AdaptiveTechnology/FEED.ME/3D Models/Clamp Boot.SLDPRT

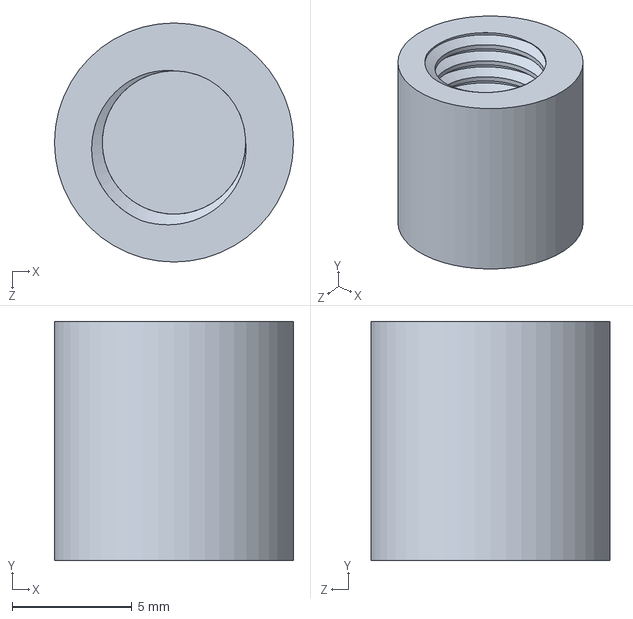
[picture p10: CAD file, 2019-04-22]
3D Models/Clamp Boot.SLDPRT
10.0 x 10.0 x 10.0 mm
