AdaptiveTechnology/FEED.ME/3D Models/End Effector.SLDPRT

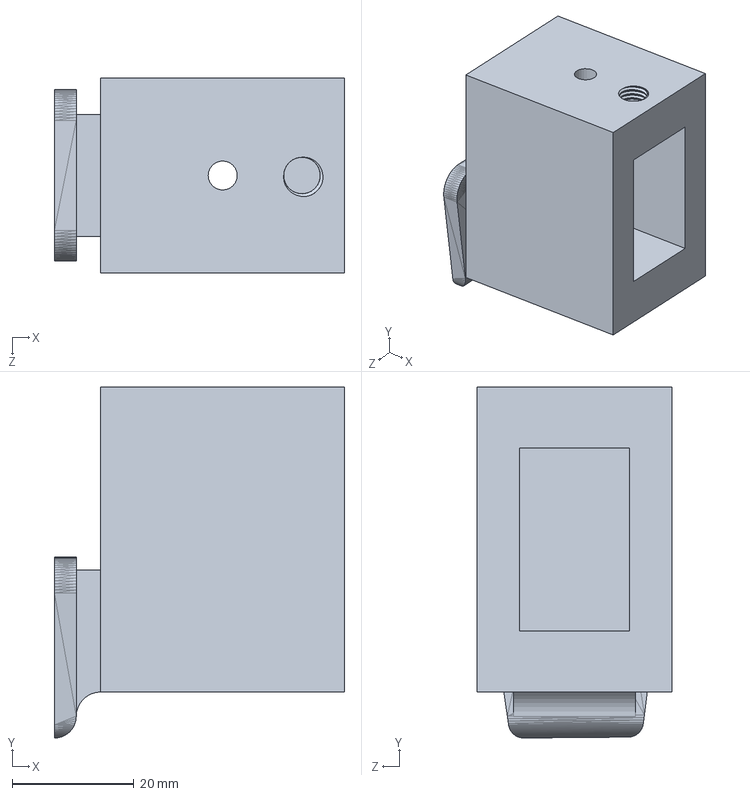
[picture p11: CAD file, 2019-04-22]
3D Models/End Effector.SLDPRT
47.6 x 57.5 x 32.0 mm
