AdaptiveTechnology/FEED.ME/(list of files, cad)

Other CAD files:
3D Models/Mounting Template.SLDPRT
3D Models/Clamp Boot.STL
3D Models/End Effector.STL
3D Models/Mounting Template.DXF
